Starlight1856/Telescope-Tracking-Drive/diagrams/Arduino-uno7.bmp

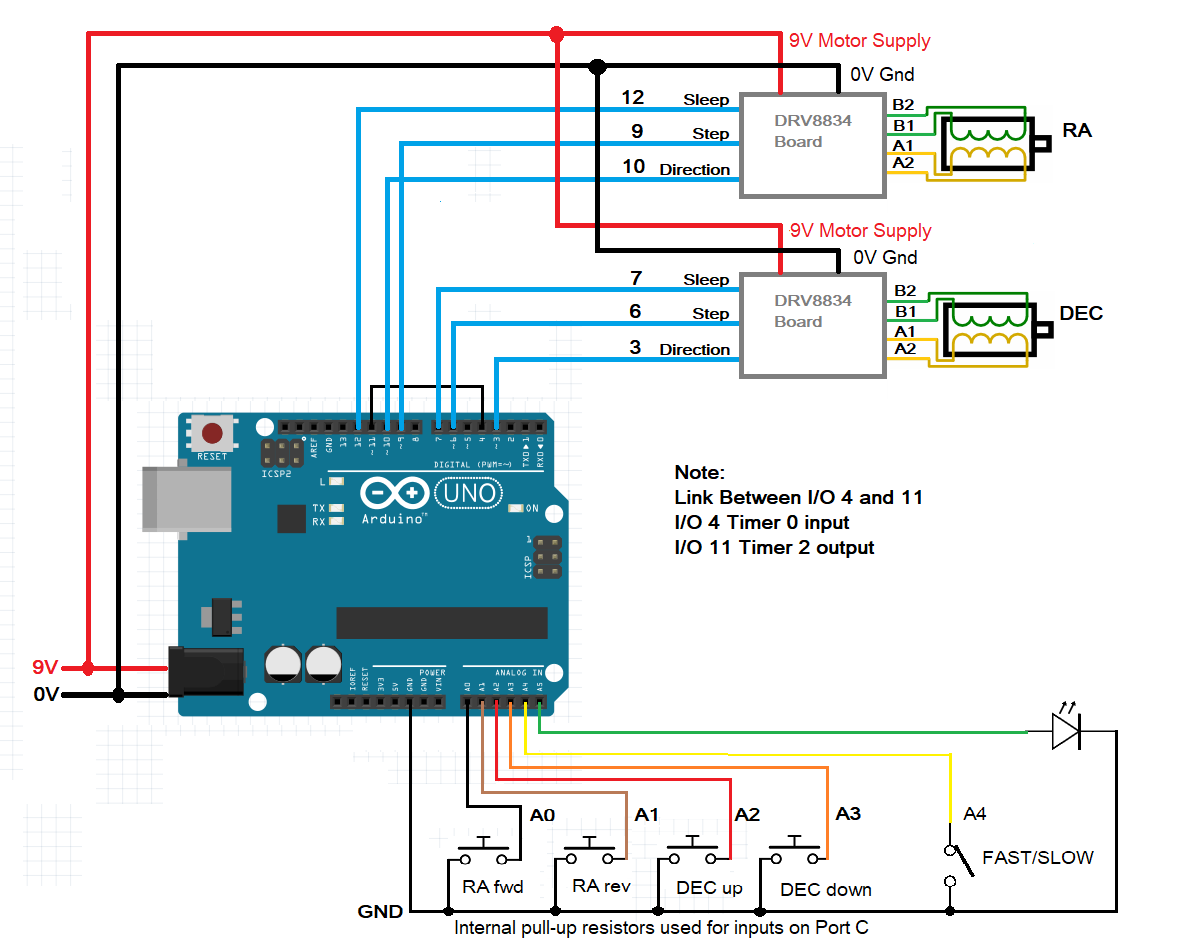
diagrams/Arduino-uno7.bmp
