Starlight1856/Telescope-Tracking-Drive/diagrams/drv8834brd.bmp

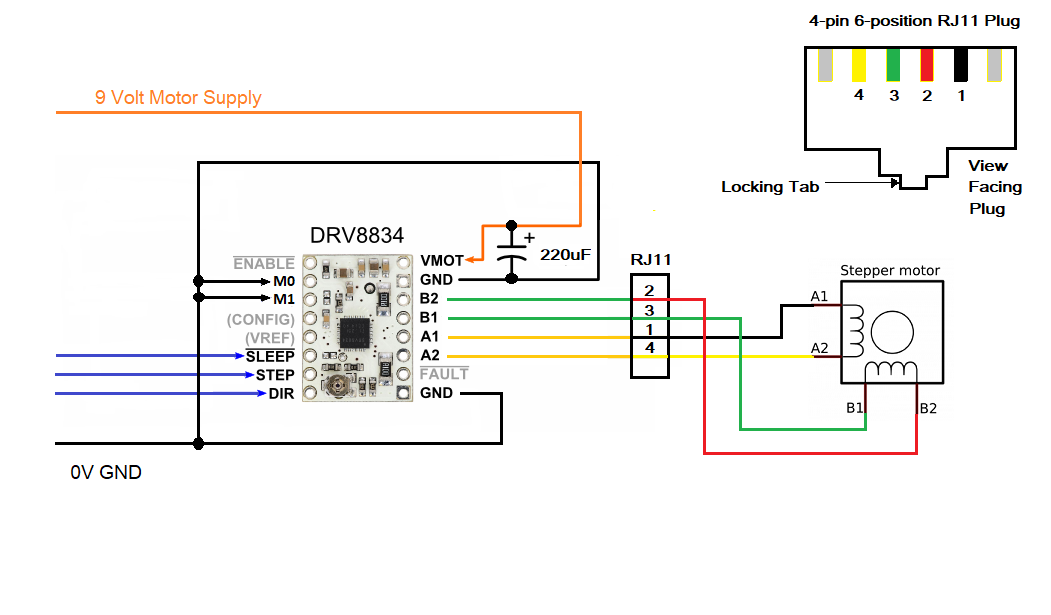
diagrams/drv8834brd.bmp
